e13h/quadcopter/TODO.md

# TODO

1.  Remove depndency on SoftwareSerial2
