e13h/quadcopter/hardware/quadcopter.brd

## EAGLE design hardware/quadcopter.brd (2022-02-11)

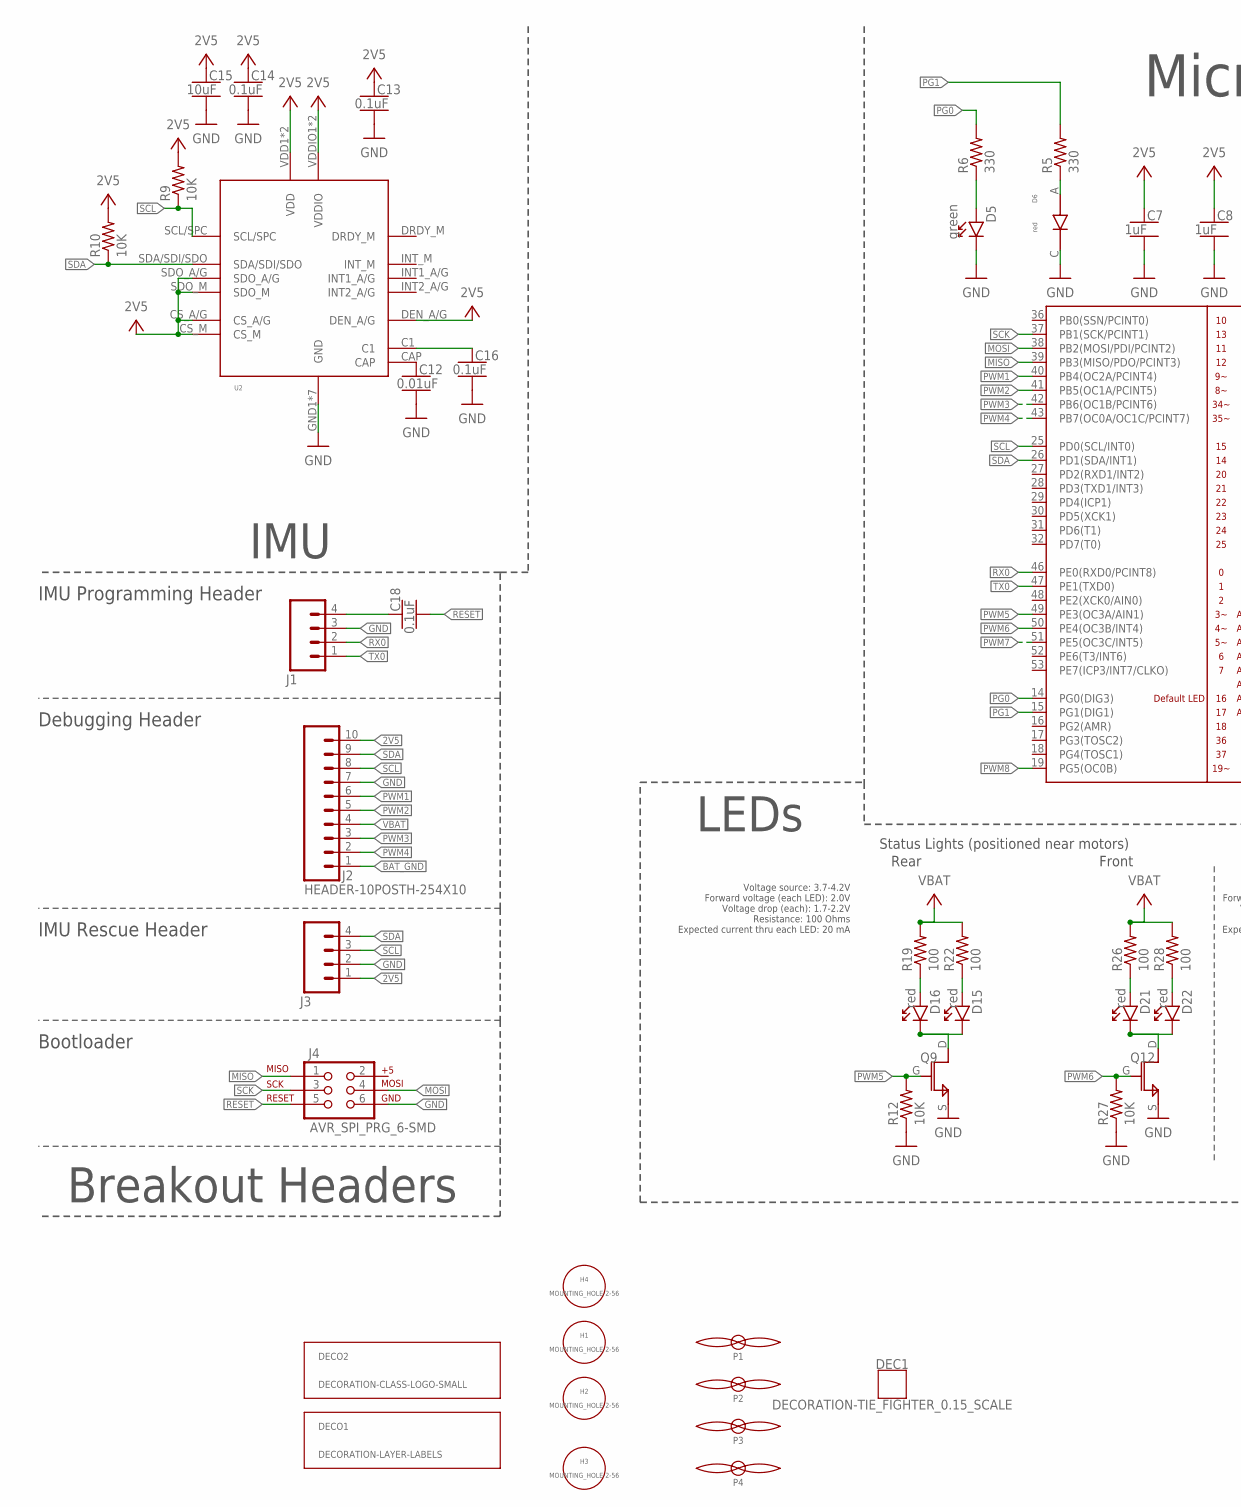
[picture p1: schematic quadcopter.sch, part in row 1, column 1]

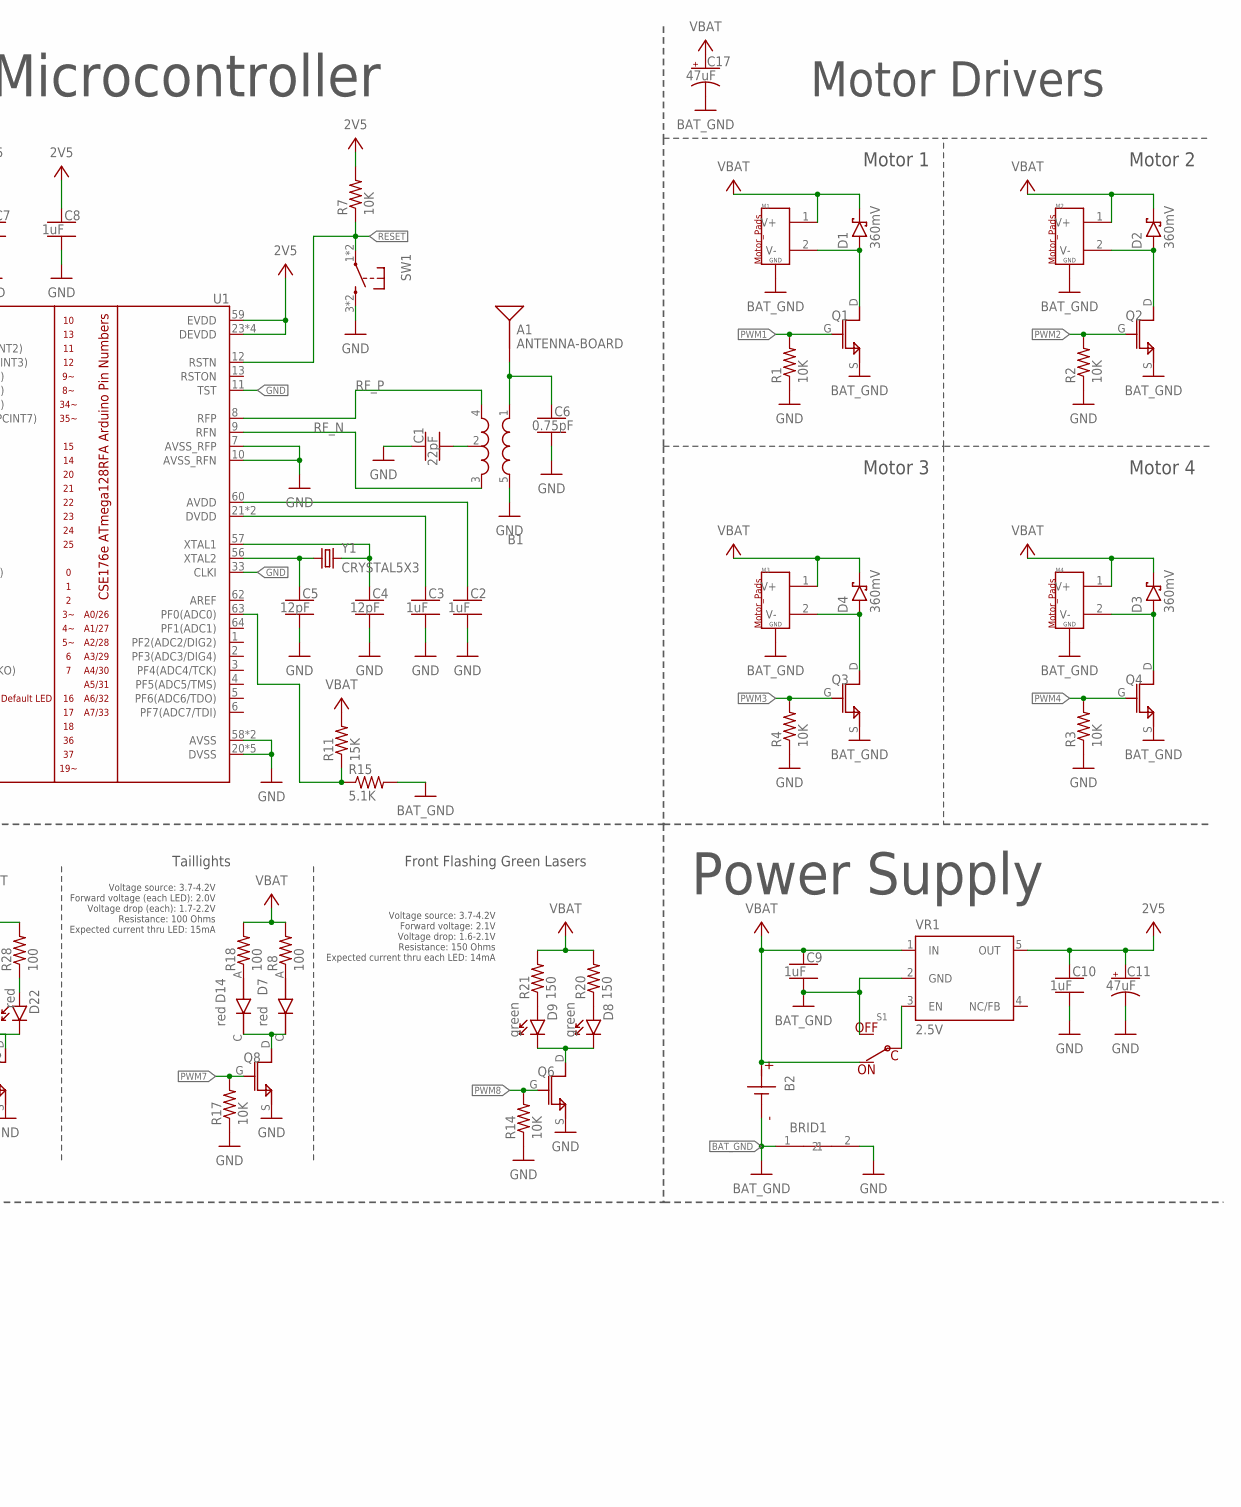
[picture p2: schematic quadcopter.sch, part in row 1, column 2]

Parts:
A1: ANTENNA-BOARD; ANT_PCB_2.4GHZ_NRF8001_1.6MM_1OZ
B1: BALUN0805; BALUN
B2: BATTERY-SMD-TH; BATTERY-COMBO
BRID1: NET_BRIDGE_5X5
C1: 22pF; CAPC2012X140_HS
C2, C3, C7, C8, C9, C10: 1uF; CAPC2012X140_HS
C4, C5: 12pF; CAPC2012X140_HS
C6: 0.75pF; CAPC2012X140_HS
C11, C17: 47uF; CAPMP3216X180
C12: 0.01uF; CAPC2012X140_HS
C13, C14, C16, C18: 0.1uF; CAPC2012X140_HS
C15: 10uF; CAPC2012X140_HS
D1, D2, D3, D4: 360mV; SODFL3516X96
D5, D8, D9: green; LEDSC125X200X120-2_HS
D6, D7, D14: red; LTST-C170EKT
D15, D16, D21, D22: red; 1206_LED_REVERSE
DEC1: DECORATION-TIE_FIGHTER_0.15_SCALE; TIE_FIGHTER_0.15_SCALE
DECO1: DECORATION-LAYER-LABELS; LAYER_LABELS
DECO2: DECORATION-CLASS-LOGO-SMALL; QUADCLASS_LOGO_SMALL
H1, H2, H3, H4: MOUNTING_HOLE-2-56; 2-56-MOUNTING-HOLE-NO-METAL
J1: HEADER-4POS-0.1IN-FEMALE-SMD-BOTTOM-ENTRY; HEADER-1X4-BOTTOM-ENTRY
J2: HEADER-10POSTH-254X10; HDRV10W63P254_10X1_2540X254H838_HS
J3: HEADER-4POS-0.1IN-FEMALE; HDRVR4W80P254_1X4_1066X254X850B
J4: AVR_SPI_PRG_6-SMD; 2X3-SMD
M1, M2, M3, M4: MOTOR_PADS_GND-MOLEX-SMD; MOLEX-0532610271
P1, P2, P3, P4: PROPELLOR-45MM; MOTOR_AND_PROP
Q1, Q2, Q3, Q4, Q6, Q8, Q9, Q12: N-MOSFET-SI2302DS; SI2302DS
R1, R2, R3, R4, R7, R9, R10, R12, R14, R17, R27: 10K; RESC2012X60_HS
R5, R6: 330; RESC2012X60_HS
R8, R18, R19, R22, R26, R28: 100; RESC2012X60_HS
R11: 15K; RESC2012X60_HS
R15: 5.1K; RESC2012X60_HS
R20, R21: 150; RESC2012X60_HS
S1: POWER-SWITCH-MFS201N-9-Z-SMD-EDGE; JS102011SAQN
SW1: PUSHBUTTON_-4.5X4.5; 4.5MM_TACTILE_SWITCH_TL3305AF160QG
U1: ATMEGA128RFA1; QFN-64
U2: IMU_LSM9DS1-LSM9DS1; LSM9DS1
VR1: 2.5V; SOT23-DBV
Y1: CRYSTAL5X3; CRYSTAL-SMD-5X3

Connections:
2V5: C7.1, C8.1, C10.1, C11.1 (+), C13.1, C14.1, C15.1, J2.10, J3.1, R7.2, R9.2, R10.2, U1.23 (DEVDD), U1.34 (DEVDD), U1.44 (DEVDD), U1.54 (DEVDD), U1.59 (EVDD), U2.CS_A/G, U2.CS_M, U2.DEN_A/G, U2.SDO_A/G, U2.SDO_M, U2.VDD1 (VDD), U2.VDD2 (VDD), U2.VDDIO1 (VDDIO), U2.VDDIO2 (VDDIO), VR1.5 (OUT)
ANTENNA: A1.FEED, B1.1 (IN), C6.1
BAT_GND: B2.2 (N), B2.G (N), B2.G2 (N), B2.G3 (N), BRID1.1, C9.2, C17.2 (-), J2.1, M1.G1 (GND), M1.G2 (GND), M2.G1 (GND), M2.G2 (GND), M3.G1 (GND), M3.G2 (GND), M4.G1 (GND), M4.G2 (GND), Q1.S, Q2.S, Q3.S, Q4.S, R15.2, S1.A (OFF), VR1.2 (GND)
GND: B1.5 (GND), BRID1.2, C1.1, C2.2, C3.2, C4.2, C5.2, C6.2, C7.2, C8.2, C10.2, C11.2 (-), C12.2, C13.2, C14.2, C15.2, C16.2, D5.C, D6.C, J1.3, J2.7, J3.2, J4.6, Q6.S, Q8.S, Q9.S, Q12.S, R1.1, R2.1, R3.1, R4.1, R12.1, R14.1, R17.1, R27.1, SW1.3 (2), SW1.4 (2), U1.7 (AVSS_RFP), U1.10 (AVSS_RFN), U1.11 (TST), U1.20 (DVSS), U1.24 (DVSS), U1.33 (CLKI), U1.35 (DVSS), U1.45 (DVSS), U1.55 (DVSS), U1.58 (AVSS), U1.61 (AVSS), U2.GND1 (GND), U2.GND2 (GND), U2.RES1 (GND), U2.RES2 (GND), U2.RES3 (GND), U2.RES4 (GND), U2.RES5 (GND)
MISO: J4.1, U1.39 (PB3(MISO/PDO/PCINT3))
MOSI: J4.4, U1.38 (PB2(MOSI/PDI/PCINT2))
unnamed: D2.2 (A), M2.2 (V-), Q2.D
unnamed: D1.2 (A), M1.2 (V-), Q1.D
unnamed: D4.2 (A), M3.2 (V-), Q3.D
unnamed: D3.2 (A), M4.2 (V-), Q4.D
unnamed: D6.A, R5.1
unnamed: C18.1, J1.4
unnamed: B1.2 (GND), C1.2
unnamed: C2.1, U1.60 (AVDD)
unnamed: C3.1, U1.21 (DVDD), U1.22 (DVDD)
unnamed: C5.1, U1.56 (XTAL2), Y1.1
unnamed: C4.1, U1.57 (XTAL1), Y1.3 (2)
unnamed: D5.A, R6.1
unnamed: C12.1, U2.CAP
unnamed: D8.C, D9.C, Q6.D
unnamed: D14.A, R18.1
unnamed: D8.A, R20.1
unnamed: D9.A, R21.1
unnamed: D7.A, R8.1
unnamed: C16.1, U2.C1
unnamed: S1.C, VR1.3 (EN)
unnamed: D16.2 (A), R19.1
unnamed: D7.C, D14.C, Q8.D
unnamed: R11.1, R15.1, U1.63 (PF0(ADC0))
unnamed: D15.2 (A), R22.1
unnamed: D15.1 (C), D16.1 (C), Q9.D
unnamed: D21.1 (C), D22.1 (C), Q12.D
unnamed: D21.2 (A), R26.1
unnamed: D22.2 (A), R28.1
PG0: R6.2, U1.14 (PG0(DIG3))
PG1: R5.2, U1.15 (PG1(DIG1))
PWM1: J2.6, Q1.G, R1.2, U1.40 (PB4(OC2A/PCINT4))
PWM2: J2.5, Q2.G, R2.2, U1.41 (PB5(OC1A/PCINT5))
PWM3: J2.3, Q3.G, R4.2, U1.42 (PB6(OC1B/PCINT6))
PWM4: J2.2, Q4.G, R3.2, U1.43 (PB7(OC0A/OC1C/PCINT7))
PWM5: Q9.G, R12.2, U1.49 (PE3(OC3A/AIN1))
PWM6: Q12.G, R27.2, U1.50 (PE4(OC3B/INT4))
PWM7: Q8.G, R17.2, U1.51 (PE5(OC3C/INT5))
PWM8: Q6.G, R14.2, U1.19 (PG5(OC0B))
RESET: C18.2, J4.5, R7.1, SW1.1, SW1.2 (1), U1.12 (RSTN)
RF_N: B1.3 (OUT2), U1.9 (RFN)
RF_P: B1.4 (OUT1), U1.8 (RFP)
RX0: J1.2, U1.46 (PE0(RXD0/PCINT8))
SCK: J4.3, U1.37 (PB1(SCK/PCINT1))
SCL: J2.8, J3.3, R9.1, U1.25 (PD0(SCL/INT0)), U2.SCL/SPC
SDA: J2.9, J3.4, R10.1, U1.26 (PD1(SDA/INT1)), U2.SDA/SDI/SDO
TX0: J1.1, U1.47 (PE1(TXD0))
VBAT: B2.1, B2.P, C9.1, C17.1 (+), D1.1 (C), D2.1 (C), D3.1 (C), D4.1 (C), J2.4, M1.1 (V+), M2.1 (V+), M3.1 (V+), M4.1 (V+), R8.2, R11.2, R18.2, R19.2, R20.2, R21.2, R22.2, R26.2, R28.2, S1.B (ON), VR1.1 (IN)

Notes on the sheet:
Motor Drivers
Motor 1
Motor 2
Motor 3
Motor 4
IMU
Breakout Headers
IMU Programming Header
Debugging Header
IMU Rescue Header
Bootloader
Power Supply
Microcontroller
LEDs
Front Flashing Green Lasers
Status Lights (positioned near motors)
Voltage source: 3.7-4.2V Forward voltage: 2.1V Voltage drop: 1.6-2.1V Resistance: 150 Ohms Expected current thru each LED: 14mA
Voltage source: 3.7-4.2V Forward voltage (each LED): 2.0V Voltage drop (each): 1.7-2.2V Resistance: 100 Ohms Expected current thru each LED: 20 mA
Voltage source: 3.7-4.2V Forward voltage (each LED): 2.0V Voltage drop (each): 1.7-2.2V Resistance: 100 Ohms Expected current thru LED: 15mA
Taillights
Front
Rear

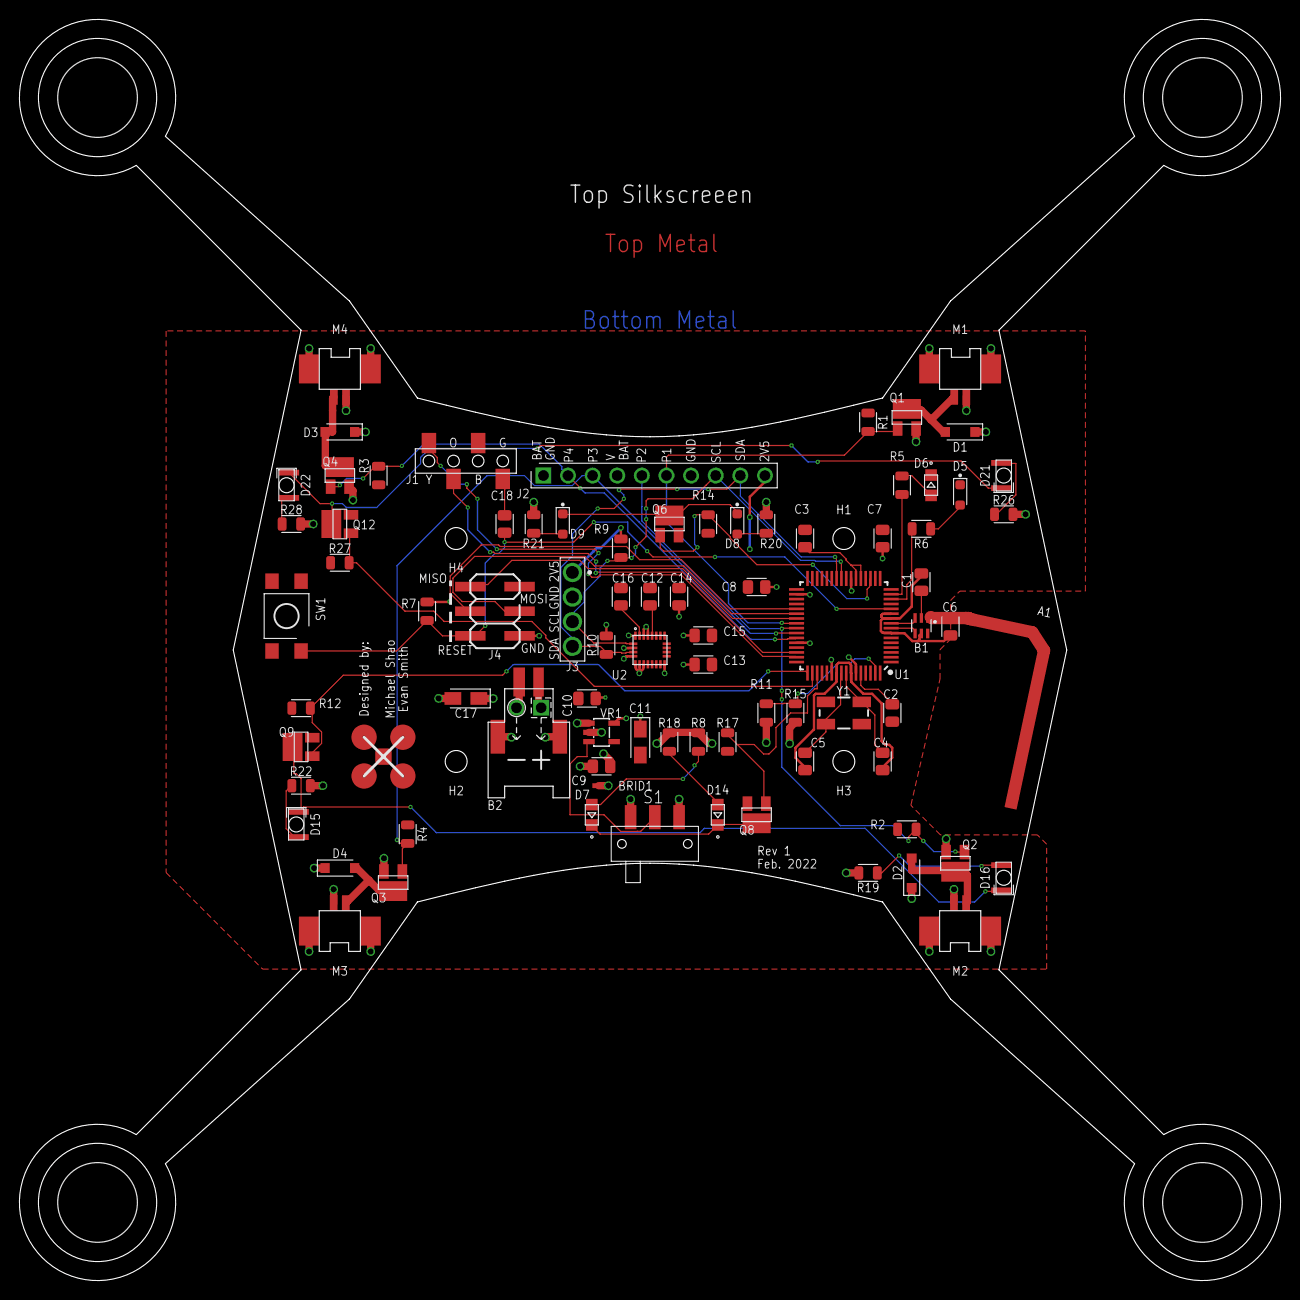
[picture p3: board quadcopter.brd from above]

Board: 4 copper layers, 130.1 x 130.1 mm, 92 parts (0 on the bottom side), 53 nets.
