e13h/quadcopter/(commit log)

2022-01-19 Running first quick check with what we have so far
    [quadcopter.sch]
2022-01-19 Replaced 3V3 with 2V5 and added GND to IMU cap pin
    [quadcopter.sch]
2022-01-19 Initial Submit
    [quadcopter.sch]
2022-01-20 Renamed parts that had $ symbols in them
    [quadcopter.sch]
2022-01-20 Replace `quadparts_prebuilt` with `quadparts_prebuilt_2022`
    [quadcopter.sch]
2022-01-20 Use parts in local custom library
    [quadcopter.sch]
2022-01-20 Attempt to fix power supply to pass quick check
    [quadcopter.sch]
2022-01-20 Added LED library and sample ground effect LED to schematic
    [quadcopter.sch]
2022-01-20 Added datasheet for ground effects LED
2022-01-20 Named LED pads
    [quadcopter.sch]
2022-01-20 Moved LED device symbol to origin
    [quadcopter.sch]
2022-01-20 Added VBAT part to power supply
    [quadcopter.sch]
2022-01-20 Minor fixes
    [quadcopter.sch]
2022-01-20 minor fix 2
    [quadcopter.sch]
2022-01-20 Updated net bridge to reference local custom library file
    [quadcopter.sch]
2022-01-20 Added LED schematics
    [quadcopter.sch]
2022-01-20 Updated LED schematics and included voltage info
    [quadcopter.sch]
2022-01-20 Updated label sizes to match others
    [quadcopter.sch]
2022-01-20 Fixed 2V5 net on both sides of R15
    [quadcopter.sch]
2022-01-20 Wired some pins to GND and switch to BAT_GND for eaglint
    [quadcopter.sch]
2022-01-20 Reorient balun
    [quadcopter.sch]
2022-01-20 Wire decoupling cap between VBAT and BAT_GND
    [quadcopter.sch]
2022-01-20 Modify IMU decoupling caps
    [quadcopter.sch]
2022-01-20 Swap C1 and CAP caps in IMU
    [quadcopter.sch]
2022-01-20 Replaced `-SMD` variant battery with `-SMD-TH` variant
    [quadcopter.sch]
2022-01-22 Modify LED schematic to meet lab specs
    [quadcopter.sch]
2022-01-28 Board Commit
    [quadcopter.brd, quadcopter.sch]
2022-01-28 Retrying the export process to run a quick check
    [quadcopter.brd, quadcopter.sch]
2022-01-28 Updated the tie fighter decoration attributes
    [quadcopter.brd, quadcopter.sch]
2022-01-28 Updated IMU pads and aligned parts to 0.5mm grid
    [quadcopter.brd, quadcopter.sch]
2022-01-28 Updated quadparts_prebuilt_2022 library to latest version from class repo
    [quadcopter.brd, quadcopter.sch]
2022-01-28 Replaced local refs to LED library with team versions
    [quadcopter.brd, quadcopter.sch]
2022-01-28 Replaced local refs to `custom_michael_shao` lbr with team version
    [quadcopter.brd, quadcopter.sch]
2022-01-28 Cleaned up `BAT_GND` traces
    [quadcopter.brd]
2022-01-28 Removed unnecessary LEDs
    [quadcopter.brd, quadcopter.sch]
2022-01-29 Moved deregulating caps and fixed IMU metal cutouts
    [quadcopter.brd, quadcopter.sch]
2022-01-29 Aligned net bridge to 0.5mm grid
    [quadcopter.brd]
2022-01-29 Code for reading the gimbals and printing to serial
2022-01-30 Fixed issues identified in human review
    [quadcopter.brd]
2022-01-31 Filled the pours 🤦🏼‍♂️
    [quadcopter.brd]
2022-01-31 Moved wires around near pwr switch so that throughhole touched gnd
    [quadcopter.brd]
2022-02-01 Gimbal calibration code implemented
2022-02-01 Adds calibration mode into main loop
2022-02-01 Added code to make calibration more practical
2022-02-01 Flesh out functions to send, validate, and print a packet
2022-02-01 Moved name for B2 out from under the part
    [quadcopter.brd]
2022-02-01 Getting the quadcopter to print out messages from the remote
2022-02-02 Print gimbal poses every 100 ms
2022-02-02 Control motors with throttle gimbal
2022-02-03 Allow remote reset sync
    [quad_firmware.ino, remote_firmware.ino]
2022-02-03 Board review question file
2022-02-04 IMU clearance suggestion
2022-02-05 Add voltage divider comment and emails
2022-02-05 Added file with questions about our board
2022-02-07 Implementing changes from design review
    [quadcopter.brd, quadcopter.sch]
2022-02-07 Update LEDs to use latest lbr version
    [quadcopter.brd, quadcopter.sch]
2022-02-11 Add board metadata for purchasing
2022-02-11 Add class logo, "created by" and date to the silkscreen
    [quadcopter.brd, quadcopter.sch]
2022-02-11 Enable sensing and filtering (#11)
    * Copy in code from `ahrs_quad` example
    * Modify loop to check for packets every iteration
    * Encapsulate IMU printing to a function
    * Get the serial console working
    * Remove magnetometer setup
    * Remove unused global constant
    (For some reason setting the baud rate with this constant wasn't working)
    * Update IMU setup
    Use high pass filter for gyro and low pass filter for accelerometer
    * Add complementary filter var on remote and quad
    Add callbacks for setting it with the knob
    * Transmit filter gain from remote to quad
    * Add startup serial print statement to remote's `setup()`
    * Bugfix: typo in #include lib
    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
    [quad_firmware.ino, remote_firmware.ino]
2022-02-15 Add PID loading, tuning, and saving
2022-02-15 Add failsafe in case eeprom loaded a nan
    [remote_firmware.ino]
2022-02-15 Add comments to PID knob tuning
2022-02-15 Transmit the PID gains to the quad
2022-02-15 Clean up and standardize the plotting/printing functions
2022-02-15 PID equation implemented
2022-02-15 Update motor indexes
2022-02-15 Update PID signature
2022-02-15 Incorporate PID control on pitch axis
2022-02-15 Add flag for printing motors to serial
2022-02-15 Constrain motor outputs
2022-02-15 Require throttle stick to be above 0 to move motors when armed
2022-02-15 Pass PID params by reference
2022-02-17 Invert yaw and pitch ranges (now they are correct)
    [remote_firmware.ino]
2022-02-17 Invert yaw and pitch requirements for arming
    [remote_firmware.ino]
2022-02-17 Update debug printing function to show more info
2022-02-17 Drop packets if the magic constant doesn't match
    [quad_firmware.ino]
2022-02-17 Remove integrator decay and set to 0 when throttle is 0
2022-02-17 Remove noisy serial print statement
2022-02-17 Added the start of yaw PID
2022-02-17 Set "armed" LED in main loop, not mixer
2022-02-17 Adds effective ceiling to throttle values
2022-02-17 Drop packets from the quad if the magic constant doesn't match
    [remote_firmware.ino]
2022-02-17 Revert "Update LCD backlight states"
    This reverts commit 96b3db611c6db34442fb9aab4834e6e85b689034.
    [remote_firmware.ino]
2022-02-17 Update gimbal calibration to use btn2 to end calibration
2022-02-17 Allow PID tuning for pitch, roll, and yaw axes
2022-02-17 Add IMU flags to debugging to make it easier to view
2022-02-18 Light up remote builtin LED too when armed
2022-02-22 Don't print "yaw filtered" since we don't run yaw through the filter
2022-02-22 Enable PID filter for yaw
2022-02-24 Center calibration and trim
2022-02-24 Set ODR to 238 Hz
2022-02-24 Cap throttle to 200 on remote side
2022-02-24 Incorporate gimbals into axis errors
    [quad_firmware.ino]
2022-02-26 Calibrate the IMU the first time the quad is armed after power on
2022-02-26 Tweak IMU setup registers to improve responsiveness
2022-02-26 Fix mixer to correctly apply yaw PID and omit gimbal commands Gimbal commands are part of the input to the PID controller.
    [quad_firmware.ino]
2022-02-26 Create dedicated trimming mode, break up calibration loop components
2022-02-26 Standardize LCD updates Fix the bugs along the way.
    [remote_firmware.ino]
2022-02-27 yaw tuning fix
2022-03-01 Invert IMU roll rate (just like we did for pitch rate)
    [quad_firmware.ino]
2022-03-01 Run PID for roll
2022-03-01 Invert roll and yaw commands
    [quad_firmware.ino]
2022-03-03 Add some additional printing flags
2022-03-03 Add a small decay to the I term in PID controller
2022-03-10 Clear the LCD on button presses
2022-03-10 Add flag for switching between FCB and custom quad
2022-03-13 Fix deadband to revert to axis centers instead of a constant value
    [remote_firmware.ino]
2022-03-13 Remove noisy print statement
2022-03-13 Enable debug printing while in calibration mode
2022-03-13 Remove arbitrary cap on gimbal throttle
2022-03-13 Refresh LCD screen on all button presses
2022-03-13 Add extra details to `print_gimbals()`
2022-03-14 Make the `BOARD_IS_FCB` flag true by default
2022-03-14 Disarm the remote after 10 seconds of inactivity when throttle is 0
2022-03-14 Use unsigned longs when working with `millis()` That's what `millis()` returns.
2022-03-14 Only set armed state to false when looking at pkt from quad The remote should only be able to enter "armed" state when gimbals are down and out. Also, remove `millis() % x == 0` from if-statement
2022-03-14 Use `update_time()` to handle debug print statements
